MarkSant/PyZebArdYolo/hardware/schematics/electronic_diagram.pdf

# PyZebArdYolo — RGB-LED stimulation circuit (Arduino Uno R3)

Each zone = 3× KY-009 (common-cathode RGB) in parallel; one colour pin per set wired to a digital pin; commons to GND. No series resistors (as built).

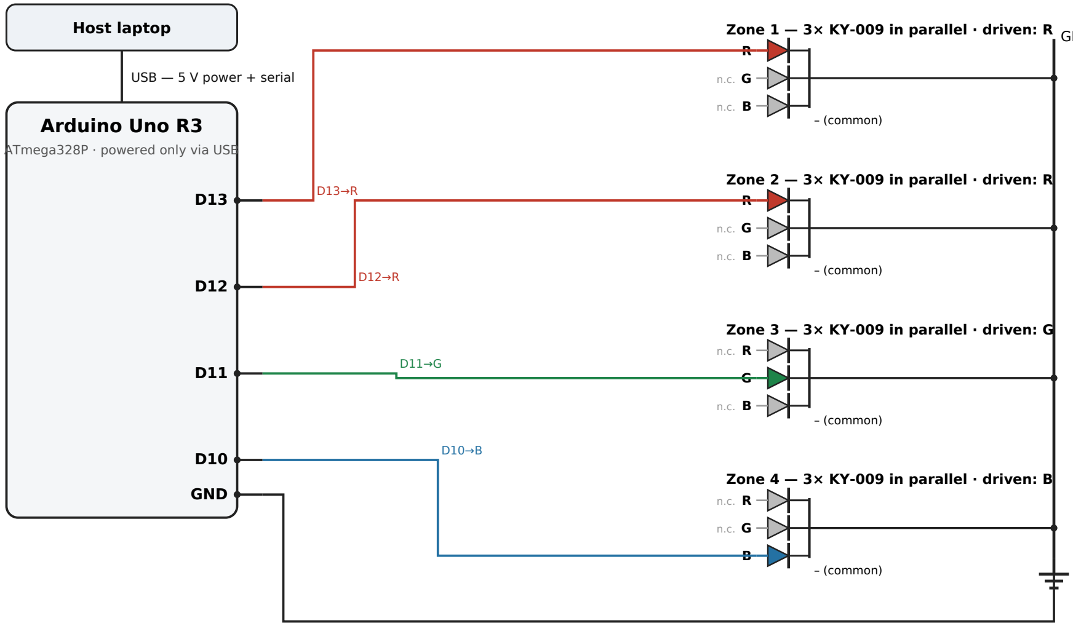
[picture p1: figure]
Host laptop; USB — 5 V power + serial; Arduino Uno R3; ATmega328P · powered only via USB; GND; – (common); n.c. B – (common) D12→R

GND Zone 1 — 3× KY-009 in parallel · driven: R

Zone 2 — 3× KY-009 in parallel · driven: R

Zone 3 — 3× KY-009 in parallel · driven: G

Zone 4 — 3× KY-009 in parallel · driven: B

Daily colour change: the 3-module set is moved to another pin (D10–D13), so a different colour pin is energised. Undriven colour pins left n.c. As built: no onboard or series resistors; LEDs driven directly from the 5 V digital pins with brief, intermittent cues (see Electrical safety).
