MarkSant/PyZebArdYolo/latency/figures/Fig9_closed_loop_latency.pdf

0 | 20 | 40 | 60 | 80
End-to-end latency (ms)

0

10

20

30

40

50

Triggers (n)

median 53.6 ms

A Software log (capture → acknowledgment), n = 368

60 | 70 | 80 | 90 | 100 | 110 | 120 | 130
Decision-to-LED latency (ms)

0

2

4

6

8

Transitions (n)

median 95.3 ms

B Optical (decision → LED), n = 36; D = 36.4 ms
