MarkSant/PyZebArdYolo/hardware/arena/README.md

# Arena — hardware design files

Custom cross-shaped acrylic tank (behavioural arena).

- `arena.skp` — editable SketchUp source (panels named by their dimensions in mm).
- `arena.stl` — 3D mesh of the tank, exported from the SketchUp source.
- `arena_dimensioned_drawing.png`, `arena_top_dimensioned.png` — dimensioned
  drawings (mm); the top view is Figure 5 of the paper.
- `arena_render_iso.png` — isometric render.

License: CERN-OHL-S v2 (see top-level `NOTICE`).
