MarkSant/PyZebArdYolo/hardware/arena/arena_dimensioned_drawing.png

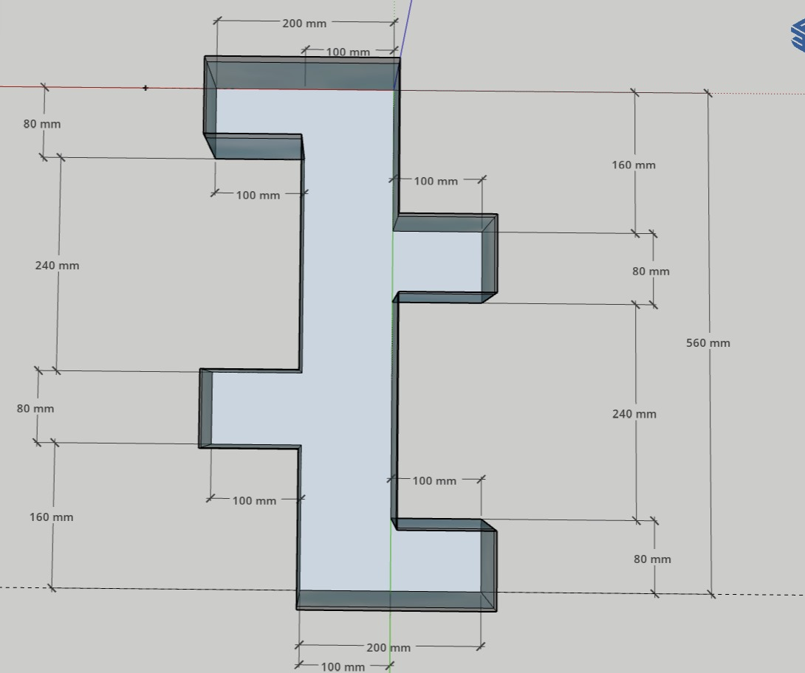
hardware/arena/arena_dimensioned_drawing.png
