MarkSant/PyZebArdYolo/hardware/arena/arena_render_iso.png

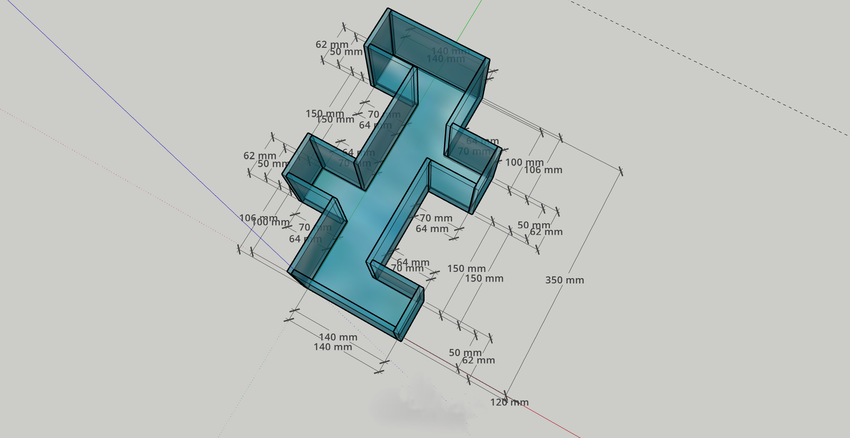
hardware/arena/arena_render_iso.png
