MarkSant/PyZebArdYolo/hardware/arena/arena_top_dimensioned.png

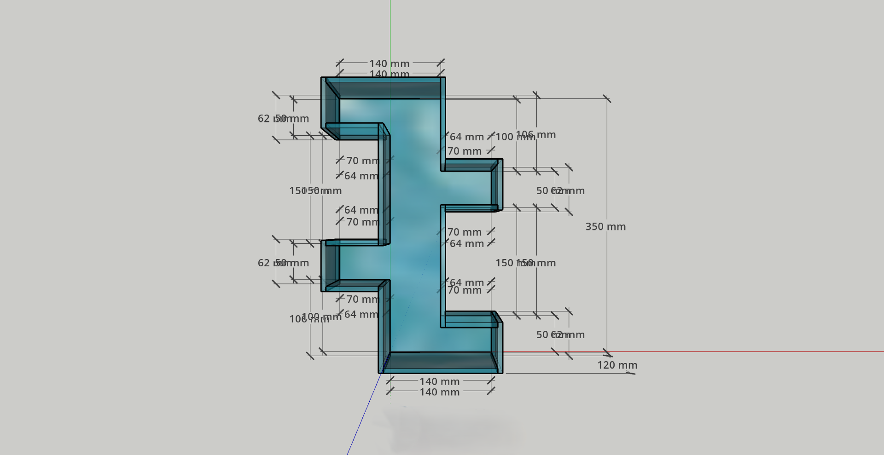
hardware/arena/arena_top_dimensioned.png
