MarkSant/PyZebArdYolo/hardware/schematics/acquisition_loop_schematic.png

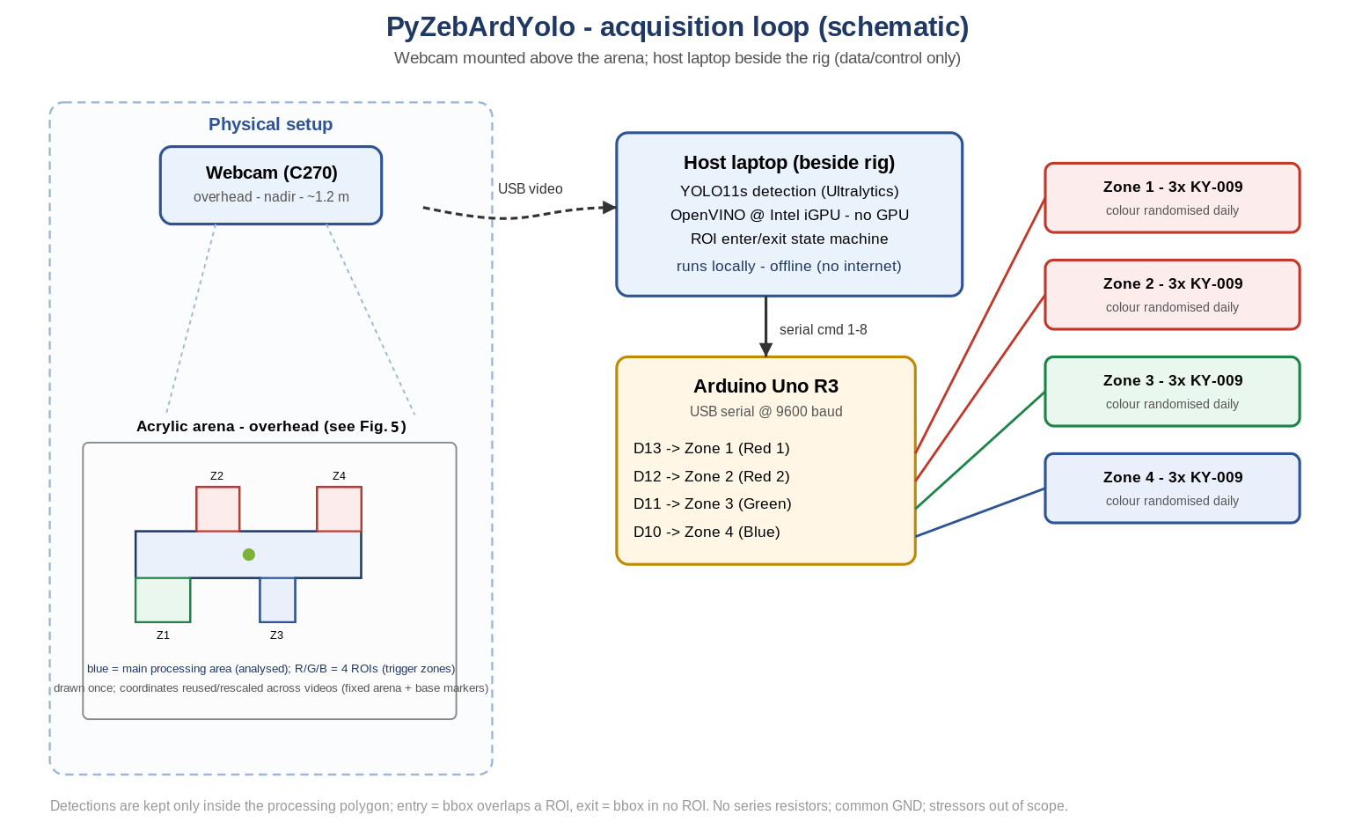
hardware/schematics/acquisition_loop_schematic.png
