MarkSant/PyZebArdYolo/hardware/schematics/electronic_diagram.png

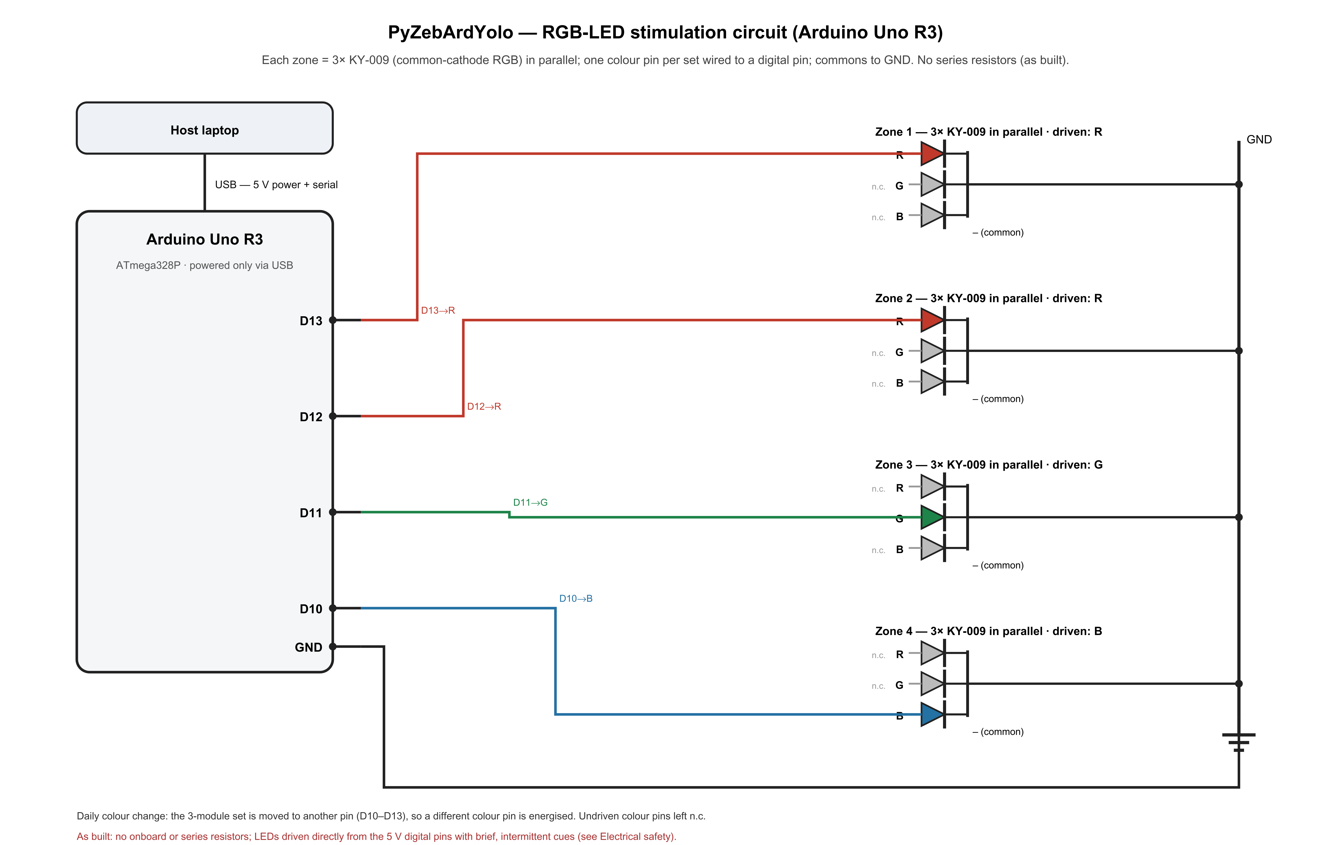
hardware/schematics/electronic_diagram.png
