MarkSant/PyZebArdYolo/latency/figures/Fig9_closed_loop_latency.png

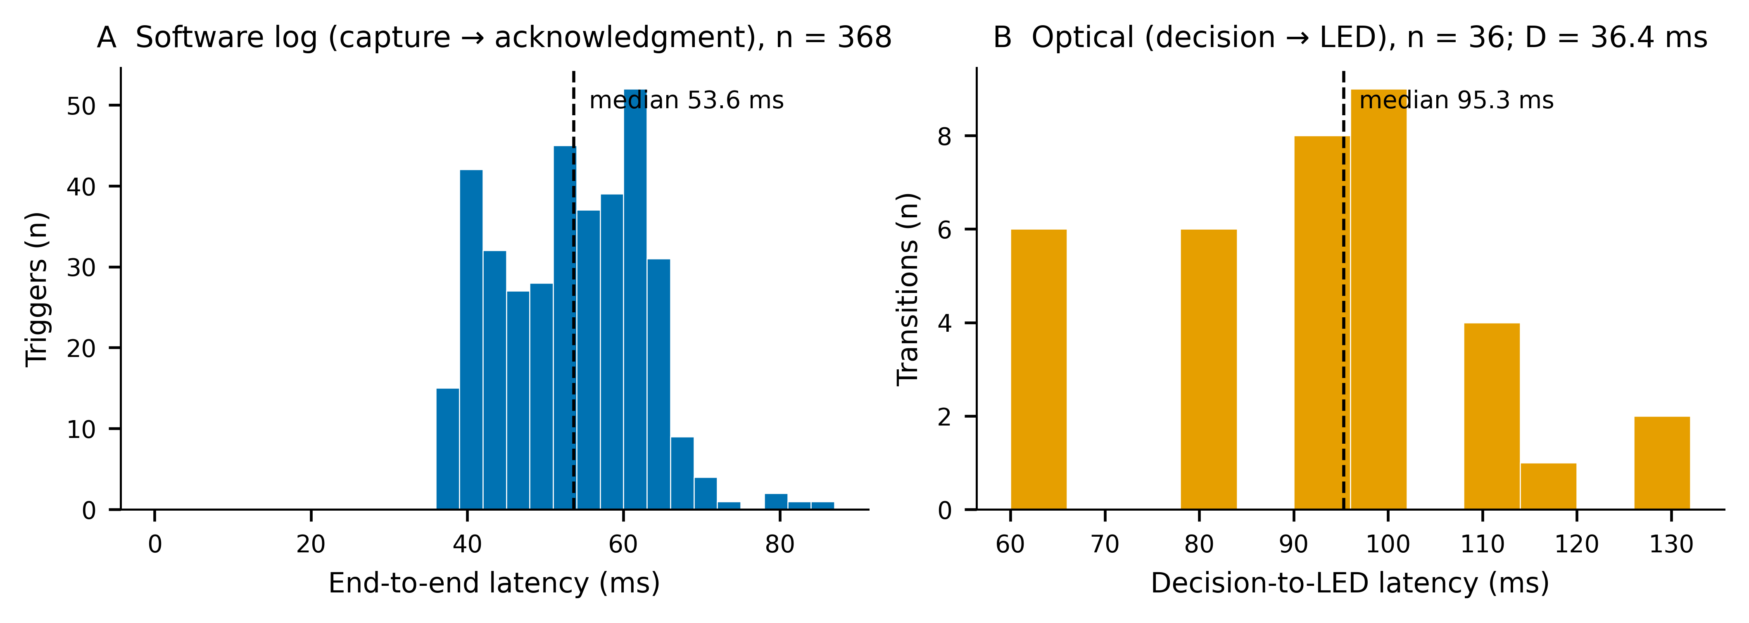
latency/figures/Fig9_closed_loop_latency.png
