MarkSant/PyZebArdYolo/hardware/arena/arena.stl

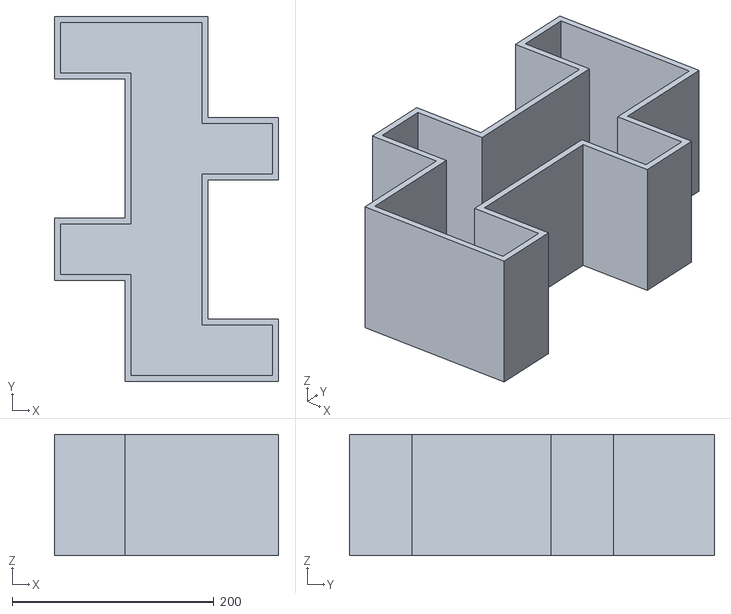
[picture p8: CAD file, 2026-07-16]
hardware/arena/arena.stl
222.0 x 362.0 x 120.0
