MarkSant/PyZebArdYolo/(list of files, cad)

Other CAD files:
hardware/arena/arena.skp
