MarkSant/PyZebArdYolo/validation/analysis/paired_coords/pares_PyZebArdYolo.csv

frame_man | frame_met | gap_frames | x_man | y_man | x_met | y_met | dx | dy | radial | video_id | metodo | grupo | dia
6.0000 | 10 | 4.0000 | 614.0000 | 396.0000 | 594.5000 | 384.5000 | -19.5000 | -11.5000 | 22.6385 | CEST_Dia1 | PyZebArdYolo | CEST | 1
36.0000 | 40 | 4.0000 | 596.0272 | 394.2380 | 604.5000 | 394.0000 | 8.4728 | -0.2380 | 8.4762 | CEST_Dia1 | PyZebArdYolo | CEST | 1
66.0000 | 70 | 4.0000 | 646.1230 | 413.6629 | 623.5000 | 411.5000 | -22.6230 | -2.1629 | 22.7262 | CEST_Dia1 | PyZebArdYolo | CEST | 1
96.0000 | 100 | 4.0000 | 595.0048 | 393.2157 | 586.0000 | 392.5000 | -9.0048 | -0.7157 | 9.0332 | CEST_Dia1 | PyZebArdYolo | CEST | 1
126.0000 | 130 | 4.0000 | 619.5415 | 396.2827 | 608.5000 | 395.0000 | -11.0415 | -1.2827 | 11.1158 | CEST_Dia1 | PyZebArdYolo | CEST | 1
156.0000 | 160 | 4.0000 | 605.2284 | 424.9089 | 610.5000 | 416.0000 | 5.2716 | -8.9089 | 10.3517 | CEST_Dia1 | PyZebArdYolo | CEST | 1
186.0000 | 190 | 4.0000 | 609.3179 | 443.3115 | 602.5000 | 435.5000 | -6.8179 | -7.8115 | 10.3684 | CEST_Dia1 | PyZebArdYolo | CEST | 1
216.0000 | 220 | 4.0000 | 648.1677 | 427.9760 | 631.0000 | 429.0000 | -17.1677 | 1.0240 | 17.1982 | CEST_Dia1 | PyZebArdYolo | CEST | 1
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
