MarkSant/PyZebArdYolo/validation/analysis/paired_coords/pares_ZebTrack.csv

frame_man | frame_met | gap_frames | x_man | y_man | x_met | y_met | dx | dy | radial | video_id | metodo | grupo | dia
6.0000 | 1 | 5.0000 | 614.0000 | 396.0000 | 614.0000 | 396.0000 | 0.0000 | 0.0000 | 0.0000 | CEST_Dia1 | ZebTrack | CEST | 1
36.0000 | 31 | 5.0000 | 596.0272 | 394.2380 | 741.8549 | 368.2903 | 145.8277 | -25.9478 | 148.1182 | CEST_Dia1 | ZebTrack | CEST | 1
66.0000 | 61 | 5.0000 | 646.1230 | 413.6629 | 790.5420 | 387.3161 | 144.4190 | -26.3468 | 146.8026 | CEST_Dia1 | ZebTrack | CEST | 1
96.0000 | 91 | 5.0000 | 595.0048 | 393.2157 | 682.8628 | 386.1565 | 87.8580 | -7.0592 | 88.1411 | CEST_Dia1 | ZebTrack | CEST | 1
126.0000 | 121 | 5.0000 | 619.5415 | 396.2827 | 682.8628 | 386.1565 | 63.3213 | -10.1263 | 64.1258 | CEST_Dia1 | ZebTrack | CEST | 1
156.0000 | 151 | 5.0000 | 605.2284 | 424.9089 | 682.8628 | 386.1565 | 77.6344 | -38.7525 | 86.7689 | CEST_Dia1 | ZebTrack | CEST | 1
186.0000 | 181 | 5.0000 | 609.3179 | 443.3115 | 628.3973 | 419.8295 | 19.0794 | -23.4820 | 30.2560 | CEST_Dia1 | ZebTrack | CEST | 1
216.0000 | 211 | 5.0000 | 648.1677 | 427.9760 | 423.7697 | 375.9117 | -224.3981 | -52.0644 | 230.3588 | CEST_Dia1 | ZebTrack | CEST | 1
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
