MarkSant/PyZebArdYolo/validation/analysis/paired_coords/pares_Observer_2.csv

frame_man | frame_met | gap_frames | x_man | y_man | x_met | y_met | dx | dy | radial | video_id | metodo | grupo | dia
0.0000 | 0 | 0.0000 | 557.0000 | 401.0000 | 557.0000 | 401.0000 | 0.0000 | 0.0000 | 0.0000 | CEST_Dia3 | Observer_2 | CEST | 3
30.0000 | 30 | 0.0000 | 634.8770 | 385.0367 | 639.9888 | 392.1933 | 5.1118 | 7.1565 | 8.7947 | CEST_Dia3 | Observer_2 | CEST | 3
60.0000 | 60 | 0.0000 | 468.2316 | 357.4329 | 473.3435 | 356.4105 | 5.1118 | -1.0224 | 5.2131 | CEST_Dia3 | Observer_2 | CEST | 3
90.0000 | 90 | 0.0000 | 304.6534 | 384.0144 | 304.6534 | 384.0144 | 0.0000 | 0.0000 | 0.0000 | CEST_Dia3 | Observer_2 | CEST | 3
120.0000 | 120 | 0.0000 | 293.4073 | 340.0527 | 292.3850 | 344.1422 | -1.0224 | 4.0895 | 4.2153 | CEST_Dia3 | Observer_2 | CEST | 3
150.0000 | 150 | 0.0000 | 326.1230 | 360.5000 | 325.1006 | 361.5224 | -1.0224 | 1.0224 | 1.4458 | CEST_Dia3 | Observer_2 | CEST | 3
180.0000 | 180 | 0.0000 | 349.6374 | 374.8131 | 345.5479 | 369.7013 | -4.0895 | -5.1118 | 6.5463 | CEST_Dia3 | Observer_2 | CEST | 3
210.0000 | 210 | 0.0000 | 368.0399 | 389.1262 | 367.0176 | 389.1262 | -1.0224 | 0.0000 | 1.0224 | CEST_Dia3 | Observer_2 | CEST | 3
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
