MarkSant/PyZebArdYolo/latency/results/led_positions_contrast.csv

session | zone | rho | y | x | contrast | n_transitions | n_events | used
lat1_1 | 1 | 0.9570 | 672 | 292 | 124.7867 | 120 | 204 | True
lat1_1 | 2 | 0.9208 | 152 | 448 | 24.6329 | 32 | 2 | False
lat1_1 | 3 | 0.9808 | 688 | 720 | 93.2691 | 22 | 33 | True
lat1_1 | 4 | 0.8700 | 116 | 840 | 40.4083 | 17 | 22 | False
lat1_2 | 1 | 0.9688 | 672 | 288 | 130.9704 | 67 | 89 | True
lat1_2 | 3 | 0.8841 | 688 | 728 | 23.3018 | 93 | 16 | False
lat1_2 | 4 | 0.6561 | 112 | 852 | 23.9586 | 75 | 2 | False
