MarkSant/PyZebArdYolo/validation/analysis/results/bland_altman_diagnostics.csv

metodo | axis | n | bias | loa_lo | loa_hi | pct_within_loa | slope | slope_ci_lo | slope_ci_hi | slope_p | bp_p | bias_change_across_range
PyZebArdYolo | X | 4114 | -2.143862 | -29.452140 | 25.164416 | 95.503160 | -0.000951 | -0.002919 | 0.001017 | 0.343505 | 0.178032 | 0.658151
PyZebArdYolo | Y | 4114 | -1.946315 | -23.991826 | 20.099195 | 94.336412 | -0.016013 | -0.020814 | -0.011211 | 0.000000 | 0.657689 | 5.845806
ZebTrack | X | 4200 | -5.368613 | -125.249863 | 114.512637 | 96.785714 | -0.075204 | -0.083820 | -0.066589 | 0.000000 | 0.011427 | 51.272396
ZebTrack | Y | 4200 | -1.642070 | -74.640933 | 71.356793 | 94.547619 | -0.158245 | -0.174472 | -0.142019 | 0.000000 | 0.009537 | 53.484696
Observer_2 | X | 903 | -1.011280 | -24.839926 | 22.817366 | 97.895903 | -0.000176 | -0.003787 | 0.003435 | 0.923744 | 0.948867 | 0.123105
Observer_2 | Y | 903 | -0.162165 | -13.409313 | 13.084983 | 94.905869 | -0.000031 | -0.006006 | 0.005943 | 0.991770 | 0.076232 | 0.011369
