MarkSant/PyZebArdYolo/validation/analysis/figures/BA_Observer_2.png

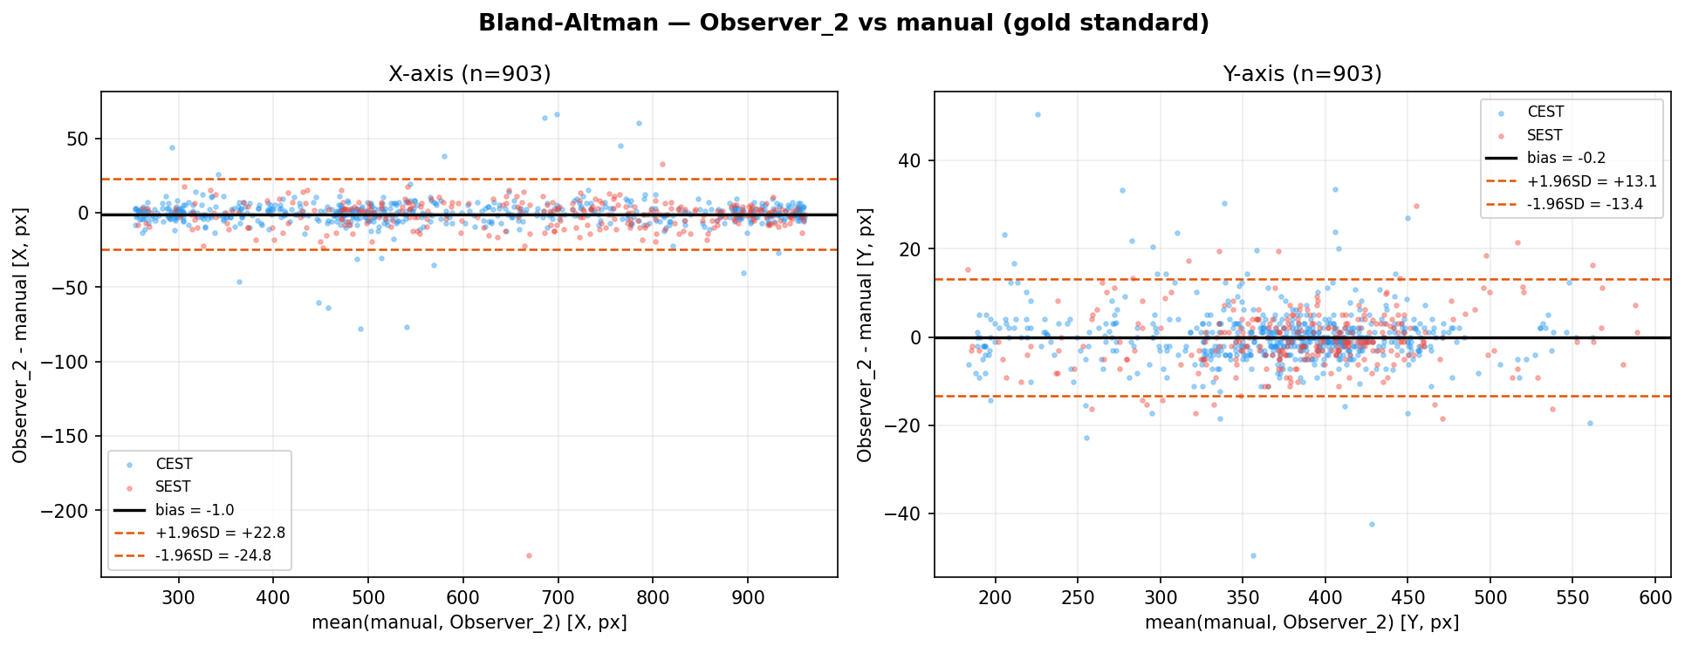
validation/analysis/figures/BA_Observer_2.png
