MarkSant/PyZebArdYolo/validation/analysis/figures/BA_PyZebArdYolo.png

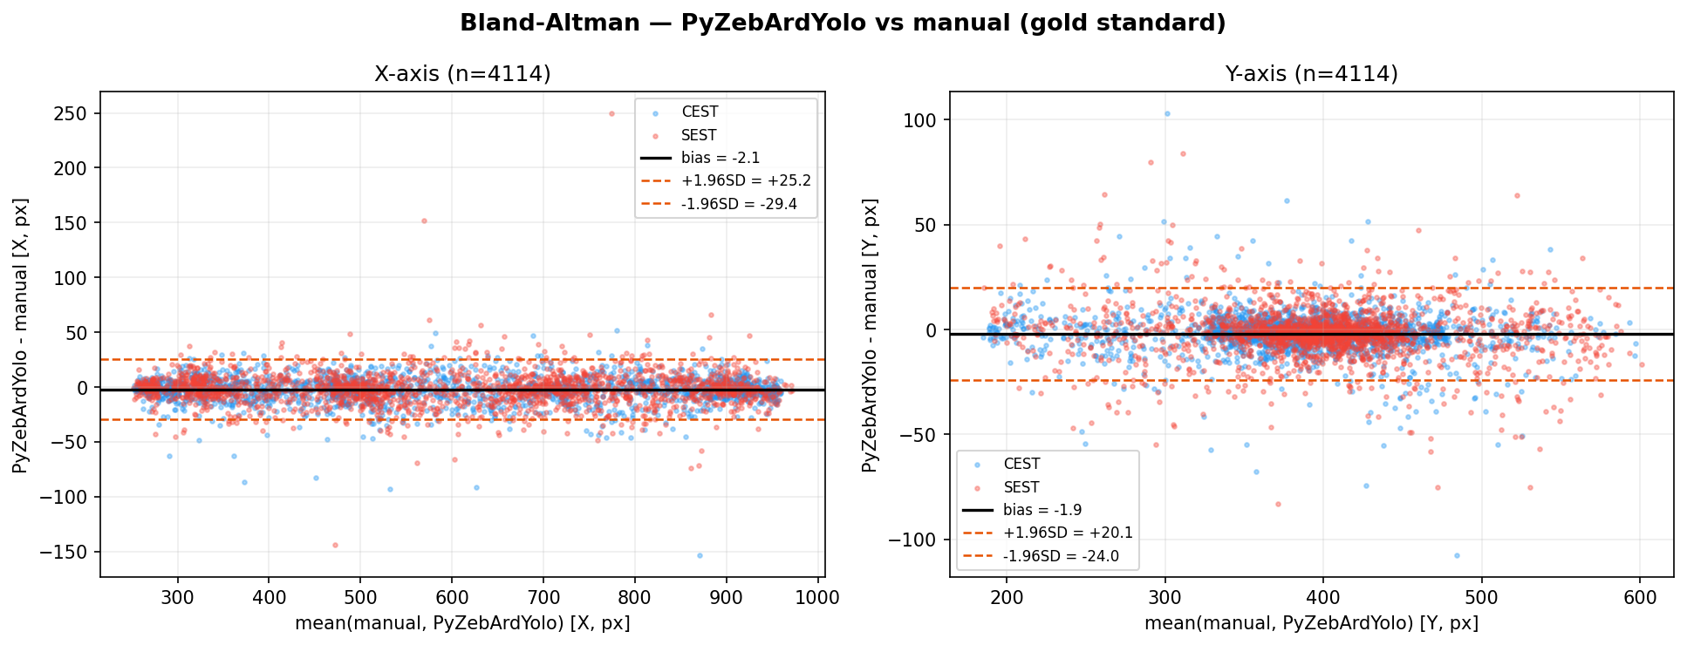
validation/analysis/figures/BA_PyZebArdYolo.png
