MarkSant/PyZebArdYolo/validation/analysis/figures/BA_ZebTrack.png

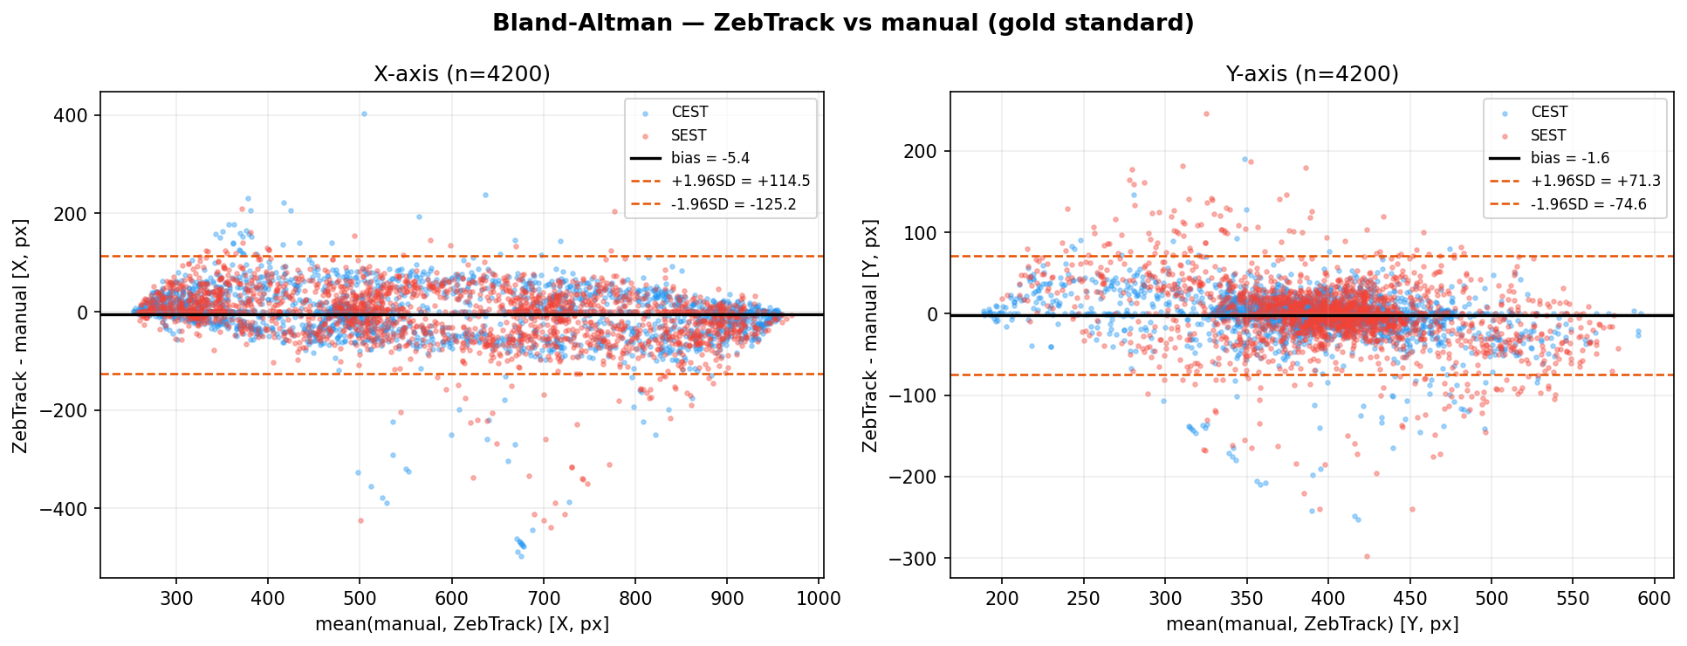
validation/analysis/figures/BA_ZebTrack.png
