MarkSant/PyZebArdYolo/validation/analysis/figures/Fig6_radial_error_by_method.png

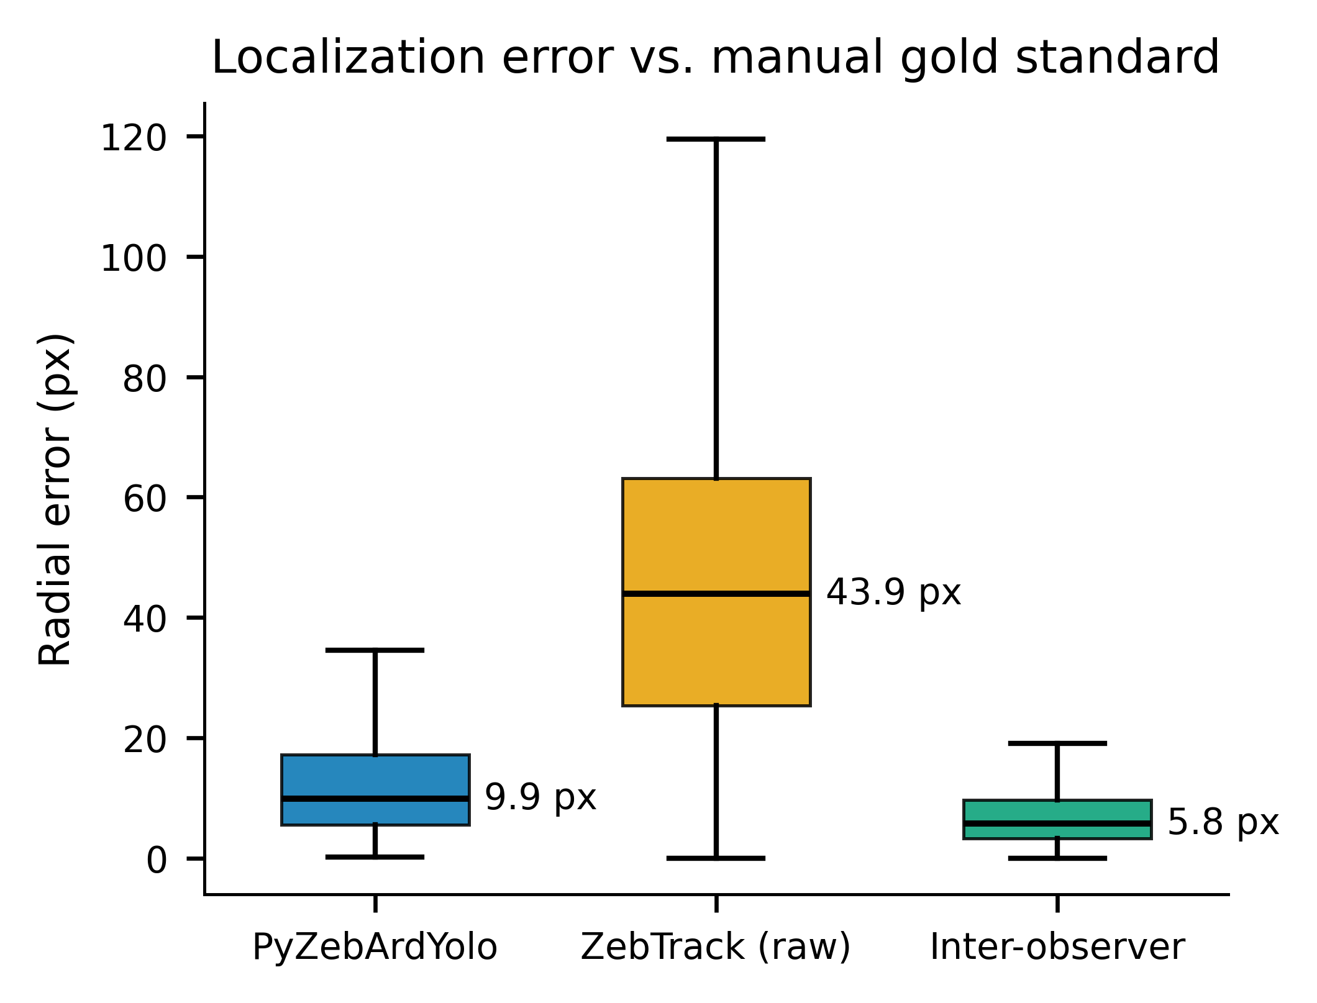
validation/analysis/figures/Fig6_radial_error_by_method.png
