MarkSant/PyZebArdYolo/validation/analysis/figures/Fig7_bland_altman_PyZebArdYolo.png

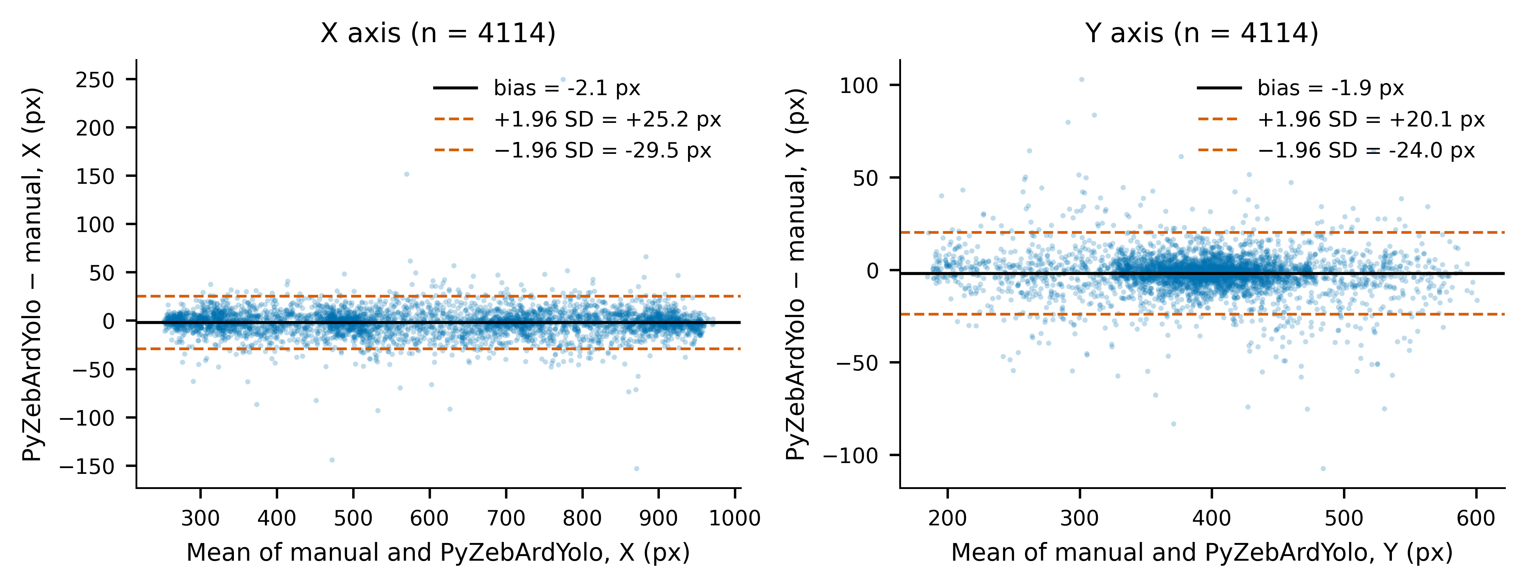
validation/analysis/figures/Fig7_bland_altman_PyZebArdYolo.png
