MarkSant/PyZebArdYolo/validation/analysis/figures/Fig8_radial_error_per_video.png

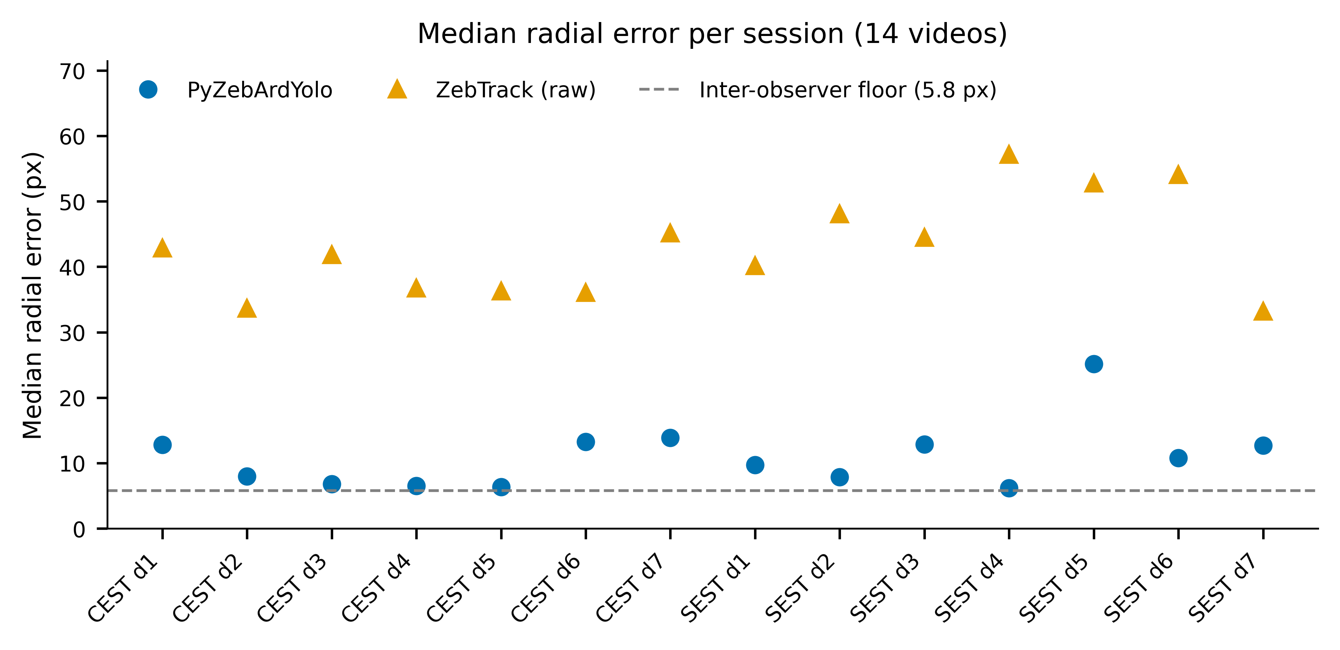
validation/analysis/figures/Fig8_radial_error_per_video.png
