MarkSant/PyZebArdYolo/validation/analysis/figures/Fig7_bland_altman_PyZebArdYolo.pdf

## X axis (n = 4114)

## Y axis (n = 4114)

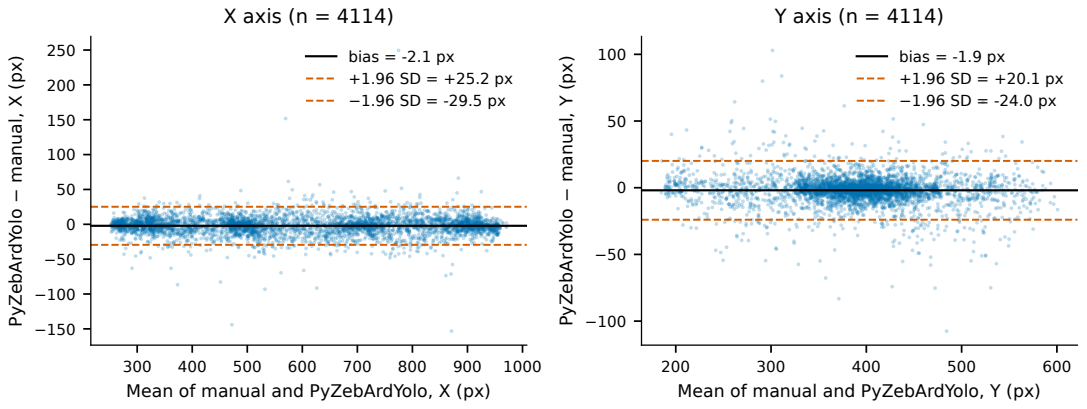
[picture p15: page 1]
bias = -2.1 px +1.96 SD = +25.2 px −1.96 SD = -29.5 px; bias = -1.9 px +1.96 SD = +20.1 px −1.96 SD = -24.0 px

PyZebArdYolo − manual, X (px)

PyZebArdYolo − manual, Y (px)

Mean of manual and PyZebArdYolo, X (px)

Mean of manual and PyZebArdYolo, Y (px)
