MarkSant/PyZebArdYolo/validation/analysis/figures/Fig8_radial_error_per_video.pdf

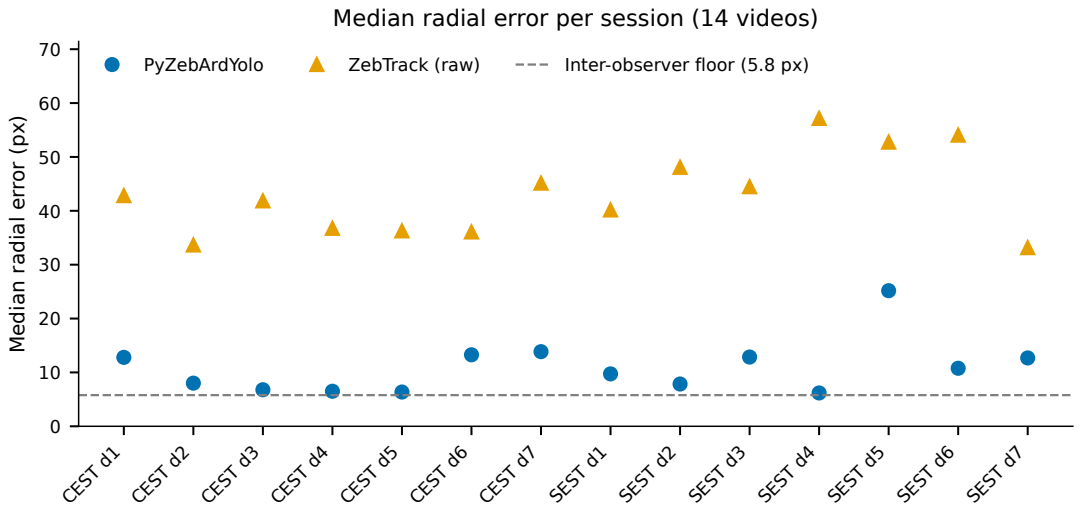
[picture p16: page 1]
CEST d1; CEST d2; CEST d3; CEST d4; CEST d5; CEST d6; CEST d7; SEST d1; SEST d2; SEST d3; SEST d4; SEST d5; SEST d6; SEST d7; PyZebArdYolo; ZebTrack (raw); Inter-observer floor (5.8 px)

Median radial error per session (14 videos)

Median radial error (px)
