MarkSant/PyZebArdYolo/(commit log)

2026-06-20 Add utility functions, tests, and project management features
    - Implemented a `set_seed` function in `utils.py` for reproducibility across random number generators.
    - Created a test suite for the `AppController` class, covering project creation workflows.
    - Added tests for the `Detector` class, including initialization, frame processing, and state machine logic.
    - Developed a comprehensive test suite for the `ProjectManager` class, validating project creation and loading.
    - Implemented tests for the `Recorder` class, ensuring correct file creation and data writing.
    - Added tests for settings loading and validation in the `Settings` class.
    - Created tests for the `FrameSource` and `Camera` cl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
    [arduino.py, camera.py]
2026-06-20 Fix Arduino port configuration and enhance connection handling
    [arduino.py]
2026-07-13 Update citation, license, and documentation; add latency logging for Arduino communication
2026-07-13 Fix merged backup regressions
    [arduino.py, camera.py]
2026-07-15 Add metadata and tracking data for SEST_1 in Dia_7
    - Created SEST_1__meta.txt with metadata including source file, frame rate, image dimensions, and generation date.
    - Added SEST_1__todas_trilhas.csv containing tracking data with frame number, time, x and y coordinates, and additional trail information.
    [3_CoordMovimento_CEST_1.csv, 3_CoordMovimento_SEST_1.csv, CEST_1__todas_trilhas.csv, SEST_1__todas_trilhas.csv, icc_per_video_Observer_2.csv, icc_per_video_PyZebArdYolo.csv, icc_per_video_ZebTrack.csv, metrics_per_video.csv]
2026-07-16 Refactor code structure for improved readability and maintainability
    [arena.skp, arena.stl]
2026-07-16 Add electronic diagram for RGB-LED stimulation circuit using Arduino Uno R3
    - Created SVG schematic diagram detailing the RGB-LED stimulation circuit.
    - Included connections for four zones, each with three KY-009 RGB LEDs in parallel.
    - Documented power supply and pin assignments for the Arduino Uno R3.
    - Added notes on daily color change mechanism and construction details.
    [bill_of_materials.csv]
2026-08-08 Fix closed-loop latency instrumentation and two live-mode freezes
    The optical validation showed the software log understating physical
    latency by 2.8x (411 ms measured vs 148 ms logged) and the declared fps
    (30) not matching the real one (38.95). A statistical audit of
    latency_log.csv found it was an instrumentation artefact, not a
    measurement: 346/354 rows with a sub-millisecond serial round trip, an
    end-to-end column near-uniform over one frame interval, and a NEGATIVE
    correlation between the serial leg and the total. Both causes were
    confirmed in code and fixed, along with two freezes found while
    validating the result on the rig.
    Instrumentation
    - arduino.py: reset_input_buffer() ran AF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
    [arduino.py, camera.py, recorder.py]
2026-10-01 Add analysis result CSV files for Bland-Altman diagnostics, localization summary, and recall summary
    - Created bland_altman_diagnostics.csv with metrics including bias and limits of agreement for different methods.
    - Added localization_summary.csv detailing radial median and percentage within thresholds for various methods.
    - Introduced recall_summary.csv summarizing recall statistics across different observers and methods.
    [1_ProcessingArea_lat1_1.csv, 1_ProcessingArea_lat1_2.csv, 2_AreasOfInterest_lat1_1.csv, 2_AreasOfInterest_lat1_2.csv, 3_CoordMovimento_lat1_1.csv, 3_CoordMovimento_lat1_2.csv, 6_Latency_lat1_1.csv, 6_Latency_lat1_2.csv]
2026-10-02 Release 1.3.1: add supplementary sensitivity script
    Pairing-offset sensitivity, validation-track cadence, latency estimate for the 10-frame configuration and manual-annotation times (validation/analysis/05_sensitivity_checks.py).
    [pairing_sensitivity.csv]
